RuneTemmerman/RuneTemmerman/readme.md

# LineFollower

Linefollower parcours


## specifications

microcontroller: ESP32

motors: GA12-N20 Tandwielmotor Dc 50/1

h-bridge: H brug DRV8833

sensors: QTR-8A reflectance sensor array

batteries: Lithium Batterij 18650

wireless communication: ingebouwde bluetooth 

distance sensor - motors: 6cm

weight: 275g

speed: 0.35m/s
