RuneTemmerman/RuneTemmerman/code/proof of concepts/hbridge/readme.md

# H-Bridge proof of concept

minimale hard- & software + stappenplan dat aantoont dat 2 motoren onafhankelijk van elkaar kunnen draaien, en (traploos) regelbaar zijn in snelheid en draairichting.
commandos A_FORWARD 150 of B_FORWARD 200 of A_BACKWARD 150 of B_BACKWARD 200
