RuneTemmerman/RuneTemmerman/code/proof of concepts/hbridge/motor proef of consept.png

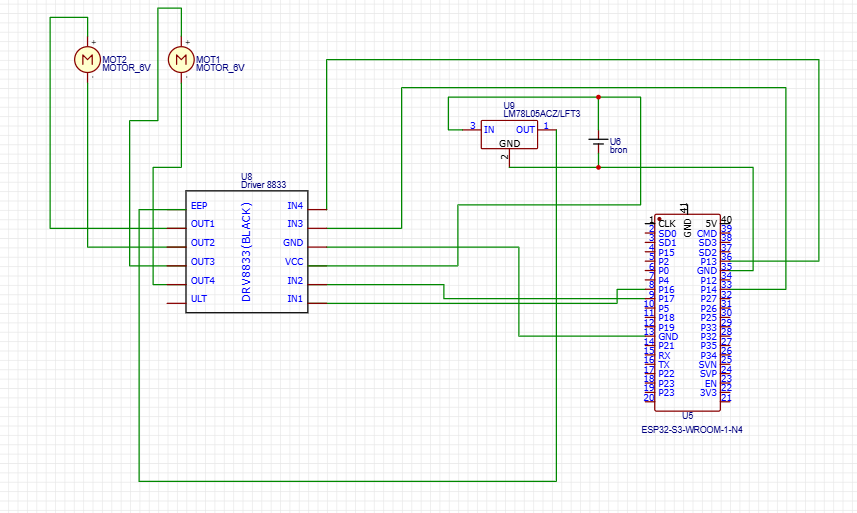
code/proof of concepts/hbridge/motor proef of consept.png
