RuneTemmerman/RuneTemmerman/code/proof of concepts/sensor/sensor proef of consept.png

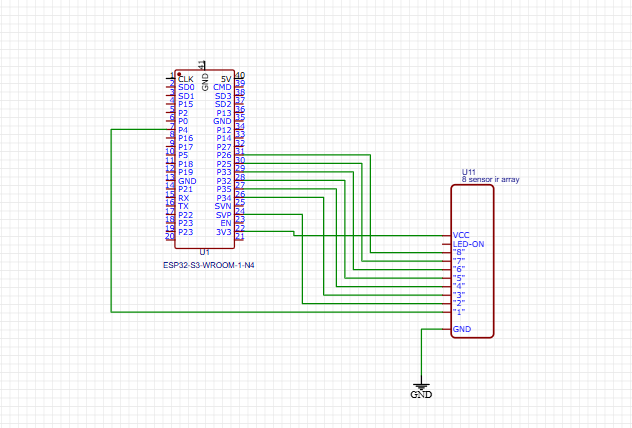
code/proof of concepts/sensor/sensor proef of consept.png
