RuneTemmerman/RuneTemmerman/technische tekeningen/elektronisch/Screenshot 2025-08-28 165140.png

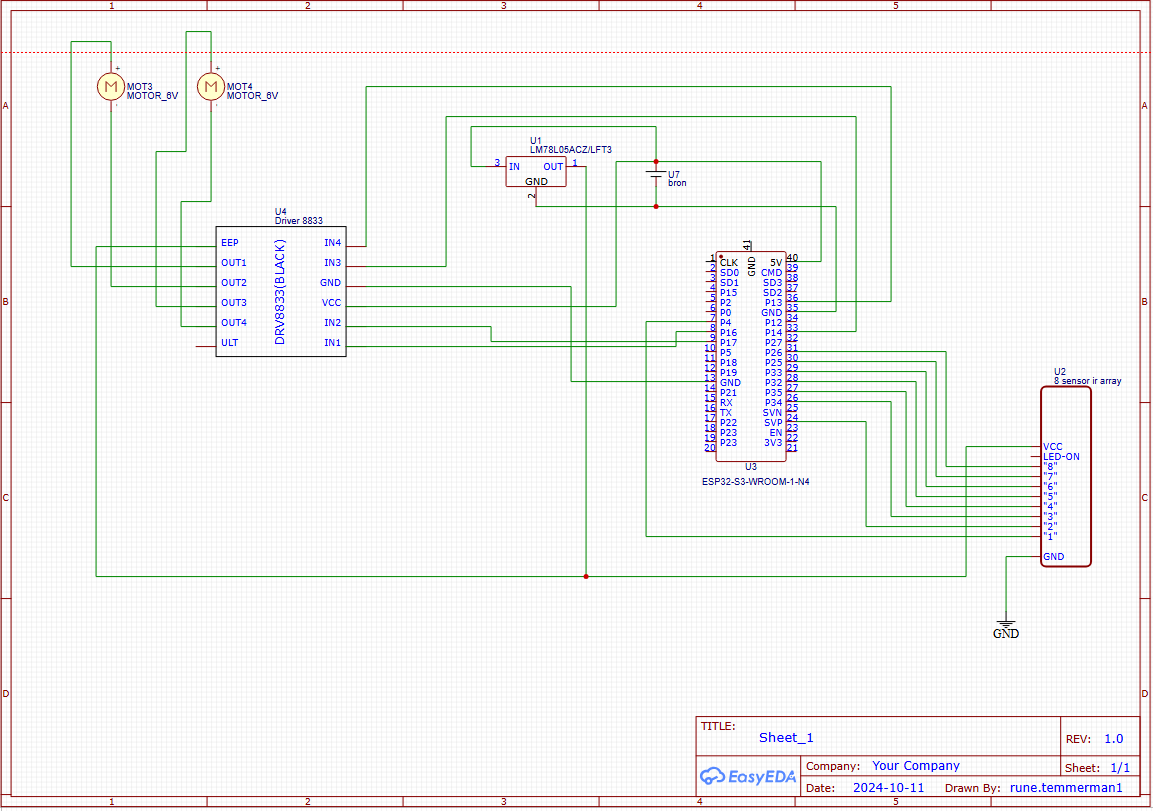
technische tekeningen/elektronisch/Screenshot 2025-08-28 165140.png
