RuneTemmerman/RuneTemmerman/bill of materials/readme.md

## bill of materials
<br />

|volgnummer|naam|omschrijving|nieuw/recup|kostprijs/stuk|aantal|subtotaal|
|---|----|---|---|---|---|---|
| 1|  QTR-8A reflectance sensor array- analog - Pololu 960  | line following sensor |  nieuw | 	€10 |  	1 | €10 |
| 2| zelfklevend zwenkwiel | 24-4 Stuks Zelfklevende Zwenkwielen 360 Graden Rotatie Zwenkwielen Mini Wielen Voor Het Verplaatsen Van Meubelen Caster Katrol |  nieuw | 	2.21 |  	1 |  	2.21 |
| 3|  ESP32 38-pins ontwikkelingsbord ESP32 Draadloze WiFi Bluetooth-module Ultra-Low Power DualCore Esp32 Breakout Board voor Smart Home  | microcontroler ESP32 |  nieuw | 	€6.41 |  	1 | €6.41 |
| 4|  GA12-N20 DC 3V 6V 12V Micro Metal Reductiemotor Tandwiel Reductiemotor 30 RPM 50 RPM 60 RPM 100 RPM 150 RPM 200 RPM 300 RPM 600 RPM 1000 RPM  | DC motoren |  DC motoren | 	€4.32 |  	2 | €8.64 |
| 5|  D-Gat Rubber Wiel Geschikt Voor N20 Motor D As Band Auto Robot Diy Speelgoed Onderdelen  | wielen voor motor |  nieuw | 	€1.43 |  	2 | €2.86 |
| 6|  1-10 stks DRV8833 Motor Drive Module 1.5A Dual H Brug DC Reductiemotor Driver Controller Board Kit  | H brug DRV8833 |  nieuw | 	€1.61 |  	1 | €1.61 |
| 7|  Nitecore i2 Oplader voor Li-ion / LiFePO4 / Ni-Mh Batterijen  | baterij oplader |  nieuw | 	€19.95 |  	1 | €19.95 |
| 8|  Batterijhouder voor LS18650 Lion cel met draden  | batterij houder |  nieuw | 	€1.29 |  	2 | €2.58 |
| 9|  Dupont Lijn 10/20/30/40Cm 40pin Mannelijk Naar Mannelijk + Mannelijk Naar Vrouwelijk En Vrouwelijk Naar Vrouwelijk Jumper Draad Dupont Kabel Voor Arduino Diy Kit  | extra wires |  nieuw | 	€2.03 |  	1 | €2.03 |
| 10|  78L05 Spannings regelaar  | bescherming esp32 |  nieuw | 	€0.29 |  	1 | €0.29 |
