RuneTemmerman/RuneTemmerman/technische tekeningen/mechanisch/volledige auto afgewerkt - karretje schets-1 (1) (2) (1).STL

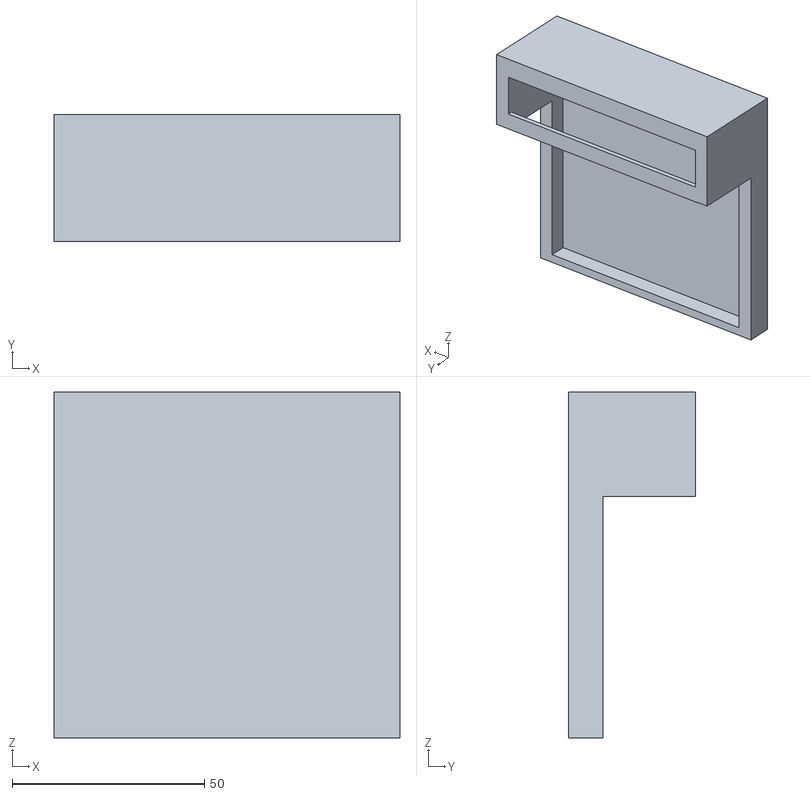
[picture p6: CAD file, 2025-08-28]
technische tekeningen/mechanisch/volledige auto afgewerkt - karretje schets-1 (1) (2) (1).STL
90.0 x 33.0 x 90.0
