RuneTemmerman/RuneTemmerman/technische tekeningen/mechanisch/gearmotor_b1r (2) (2) (1).stl

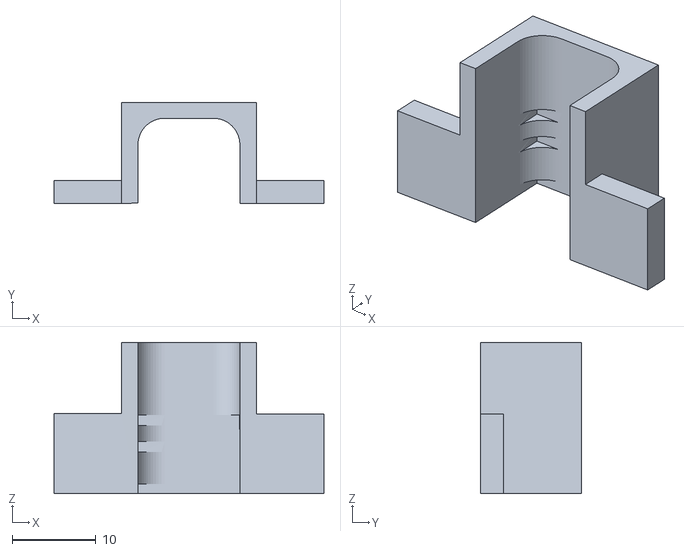
[picture p7: CAD file, 2025-08-28]
technische tekeningen/mechanisch/gearmotor_b1r (2) (2) (1).stl
32.3 x 12.1 x 18.1
