RuneTemmerman/RuneTemmerman/images/IMG_4122.JPG

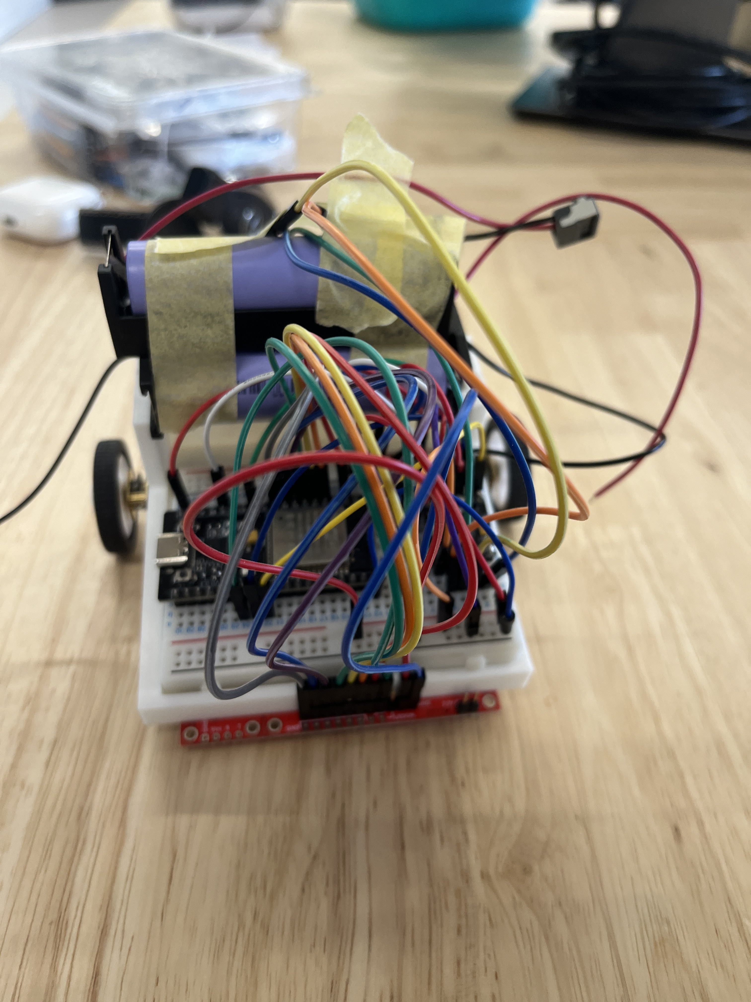
[picture p1: images/IMG_4122.JPG]
images/IMG_4122.JPG
